Vily1998/CPU-Implementation-based-on-Proteus/截图 (5).jpg

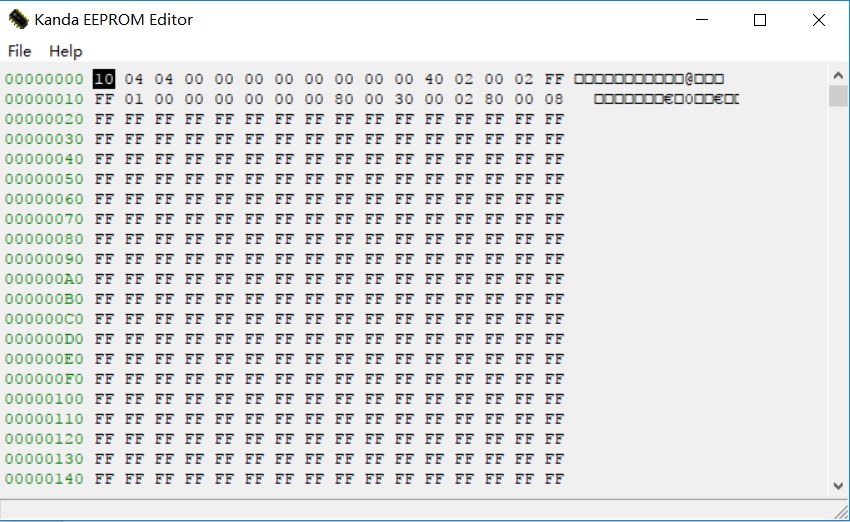
截图 (5).jpg
