Vily1998/CPU-Implementation-based-on-Proteus/微程序流程图.pptx

11
MBUS
LIR
PCINC
ARINC
P1

00
PCBUS
LAR

INT=0

1B
PUSH
RBUS
LAR

IN
1100

0C
MBUS
LAR
PCINC
STOP

18
SBUS
MEMW
P3

P3

1A
INTDI
PCBUS
LIAR

INT=1

P1

1D
SBUS
LPC

LAD
1001

09
MBUS
LAR
PCINC

15
MBUS
LDT
DRW
P3

1C
TRI
S=1010
M
ABUS
MEMW
STOP

JMP
1010

0A
MBUS
LPC
P3

JC
0100

04
P2

EI
1011

0B
INTEN

OUT
1101

0D
MBUS
LAR
PCINC

STP
1110

ADD
0001

01
S=1001
CIN
ABUS
LDT
DRW
LDC
P3

SUB
0010

02
S=0110
ABUS
LDT
DRW
LDC
P3

CLA
0011

03
M
S=0011
ABUS
LDT
DRW
P3

IRET
0101

PUSH
0110

06
PUSH
RBUS
LAR

16
S=1010
M
ABUS
MEMW
P3

POP
0111

07
RBUS
LAR

STO
1000

08
MBUS
LAR
PCINC

14
S=1010
MEMW
M
ABUS
P3

05
RBUS
LAR

1E
MBUS
LDT
TRI
DRW
POP

1F
IABUS
LPC
P3

0E
STOP
P3

C=0

P2

12
P3

C=1

13
PCADD
P3

17
MBUS
LDT
DRW
POP
P3

19
MBUS
LDO
P3

## Slide 2

memory
ROM | 0000-7FFF | 测试程序 + 初始数据
RAM | 8000-CFFF | 主程序写入的数据
| D000-DFFF | 中断写入的数据
| E000-EFFF | 栈
| F000-FFFF | I/O

## Slide 3

元件一览表
元件名 | | | 功能
ALU | 算术逻辑运算单元 | Arithmetic logic state | 运算，主要利用74ls181和74ls182芯片实现。
PRO | 处理程序 | Processor | 寄存器+选择器，内含1个累加器AC，三个寄存器R0,R1,R2，通过输入信号选择写入的信号和ALU运算的操作数，DRW信号控制写操作。
DR | 数据缓冲寄存器 | Data register | 用来暂时存放ALU的运算结果。
RAM+ROM | 存储器 | Random access memory Read only memory | 内存部分，用两片27C512（64K 八位ROM）芯片做成地址为16位的ROM部分，用两片64K八位RAM芯片实现地址为16位的RAM。
AR | 地址寄存器 | Address register | 用来记录将要访问的内存地址，可以通过LAR信号完成将总线上数据置入的操作，可以通过ARINC信号完成地址自增操作。
PC | 程序计数器 | Program counter | 用来记录当前执行的程序地址，可以通过PCINC完成地址自增操作， 通过PCADD进行地址转移，从而使程序可以循环执行。
IR | 指令寄存器 | Instruction register | 用来存储当前执行的指令，在取值周期通过置数信号LIR有效将取出的地址置入IR。
TIME | 时序电路 | Time | 生成四个相邻且互不相重合的时钟脉冲，用来控制整个程序的时序执行。
ITC | 中断触发电路 | Interrupt trigger circuit | 产生中断信号，在pause按钮按下后产生一个中断请求，并在中断程序执行周期内禁止其他中断请求。
IAR | 中断地址寄存器 | Interrupt address register | 记录终端时程序执行到了地址，在LAR信号作用下将中断地址存入IAR，在中断结束后将中断地址返回。

## Slide 4

元件一览表（续）
元件名 | | | 功能
PSW | 状态字寄存器 | Programming status word register | 记录C信号的状态，可以在程序进入中断时通过TRA信号切换至中断模式，保留主程序的状态字，同时可以存储中断程序的状态字。
SAR | 栈地址寄存器 | Stack address register | 用来存放栈地址，配合push，pop操作实现栈结构。
CM | 控制存储器 | Command register | 将指令转换成40位微地址。
MCR | 微命令寄存器 | Microcommand register | 存储微命令，对垂直型微命令进行译码。本设计采用水平型微指令，无需译码。
ATL | 地址转移逻辑 | Address transfer logic | 通过P字段判别对微指令给出的下一位微地址。
IN | 输入元件 | Input element | 配合IN指令和中断指令，实现程序执行时输入数据或地址。
OUT | 输出元件 | Output element | 配合OUT指令，实现程序执行时查询内存指定区域的数据。
RC | 寄存器控制器 | Register controller | 实现指令和中断微指令对通用寄存器的选择。

## Slide 5

分工一览表
姓名 | 自制元件 | 工程设计
陈博 | DR,AR,PC,SAR,PSW,ATL | 12条微指令设计，时序分配，地址转移逻辑设计，程序正确性调试,栈存在逻辑设计，数据流动情况分析，控制开关复用模式设计。
刘佳玮 | IR,IAR,MCR,ITC,TIME,RC | 18条微指令设计，中断电路设计，测试程序设计，程序正确性调试，时序产生逻辑设计，总线使用情况分析，输入输出逻辑设计。
张绍磊 | RAM+ROM,CM,ALU,PRO，Python写入ROM程序 | 指令格式设计，微指令代码编写，ROM数据存储，测试程序设计，程序正确性调试，中间信号显示设计，微指令译码逻辑设计。
