Vily1998/CPU-Implementation-based-on-Proteus/演示文稿1.pptx

开关说明
START | 1.开机功能，一次脉冲后开始产生时序信号 2.输入确认功能，程序等待输入时，输入完成后，通过一次START脉冲继续执行程序。
PCCLR | 1.PC清零功能，开机后通过一次PCCLR脉冲，可以将指令地址清零，回到程序的开始地址。
STEP | 1.操作模式切换开关，当STEP为0时，程序为连续运行模式，当STEP为1时，程序为单排运行模式。
PAUSE | 1.程序中断请求信号，单击PAUSE，程序开始中断。

## Slide 2

操作步骤
1.主程序操作步骤
1）开始PROTUES仿真
2）点摁PCCLR，清零PC
3）点摁START，开始执行程序
2.I/O交换
1）当程序运行到IN指令后，就需要我们从输入区输入数据。
2）此时，程序会停止运行，在输入区输入需要的数据。
3）输入完成后，单击START确认输入，继续运行程序。
3.中断操作步骤
1）单击PAUSE，产生中断请求。
2）程序将继续运行，直到程序执行完当前指令，然后程序将停止等待输入。
3） 在输入区输入中断地址，在我们设计的 程序中，两个中断子程序分别位于 3000和3100。输入完地址后，单击START确认输入，继续运行程序。

## Slide 3

简单测试程序
内存地址 | 汇编指令 | 机器代码 | AC | R1 | R2 | R3 | 说明
0000 | LAD(0010)->RI | 9100 | 0000 | 0008 | 0000 | 0000 | 将地址0010的数据 存入R1
0001 | | 0010
0002 | LAD(0011)->R2 | 9200 | 0000 | 0008 | 0005 | 0000 | 将地址0011的数据 存入R2
0003 | | 0011
0004 | ADD R1 | 1400 | 0008 | 0008 | 0005 | 0000 | AC+R1->AC
0005 | SUB R2 | 2800 | 0003 | 0008 | 0005 | 0000 | AC-R2->AC
0006 | STO AC->(8000) | 8000 | 0003 | 0008 | 0005 | 0000 | 将AC的数据 存入地址8000
0007 | | 8000
0010 | | 0008 | | | | | 数据
0011 | | 0005 | | | | | 数据

## Slide 4

内存地址 | 汇编指令 | 机器代码 | AC | R1 | R2 | R3 | 说明
000D | LAD(4002)->R3 | 9300 | 0000 | A000 | 6000 | 2000 | 将地址4002的数据 存入R3
000E | | 4002
000F | PUSH AC | 6081 | 0000 | A000 | 6000 | 2000 | AC数据入栈
0010 | CLA | 3000 | 0000 | A000 | 6000 | 2000 | 清零AC
0011 | POP AC | 7000 | 0000 | A000 | 6000 | 2000 | 栈顶数据进入AC
0012 | ADD R3 | 1C00 | X000 (X不断+2) | A000 | 6000 | 2000 | AC+R3->AC
0013 | JC 02 | 4002 | X000 | A000 | 6000 | 2000 | 通过C判断是否跳转之0016
0014 | JMP(000F) | A000 | X000 | A000 | 6000 | 2000 | 跳转至000F
0015 | | 000F
0016 | STP | E000 | | | | | 停机

## Slide 5

内存地址 | 汇编指令 | 机器代码 | 说明
3000 | SUB R3 | 2C00 | AC-R3->AC
3001 | SUB R3 | 2C00 | AC-R3->AC
3002 | EI | B000 | 中断允许
3003 | IRET | 5000 | 中断返回
3100 | IN | C000 | 从输入区输入数据
3101 | | F000
3102 | ADD R3 | 1C00 | AC+R3->AC
3103 | OUT | D000 | 输出数据
3104 | | F000
3105 | EI | B000 | 中断允许
3106 | IRET | 5000 | 中断返回

## Slide 6

内存地址 | 汇编指令 | 机器代码 | 说明
4000 | | A000 | 数据
4001 | | 4000 | 数据
4002 | | 2000 | 数据
