Vily1998/CPU-Implementation-based-on-Proteus/截图 (2).jpg

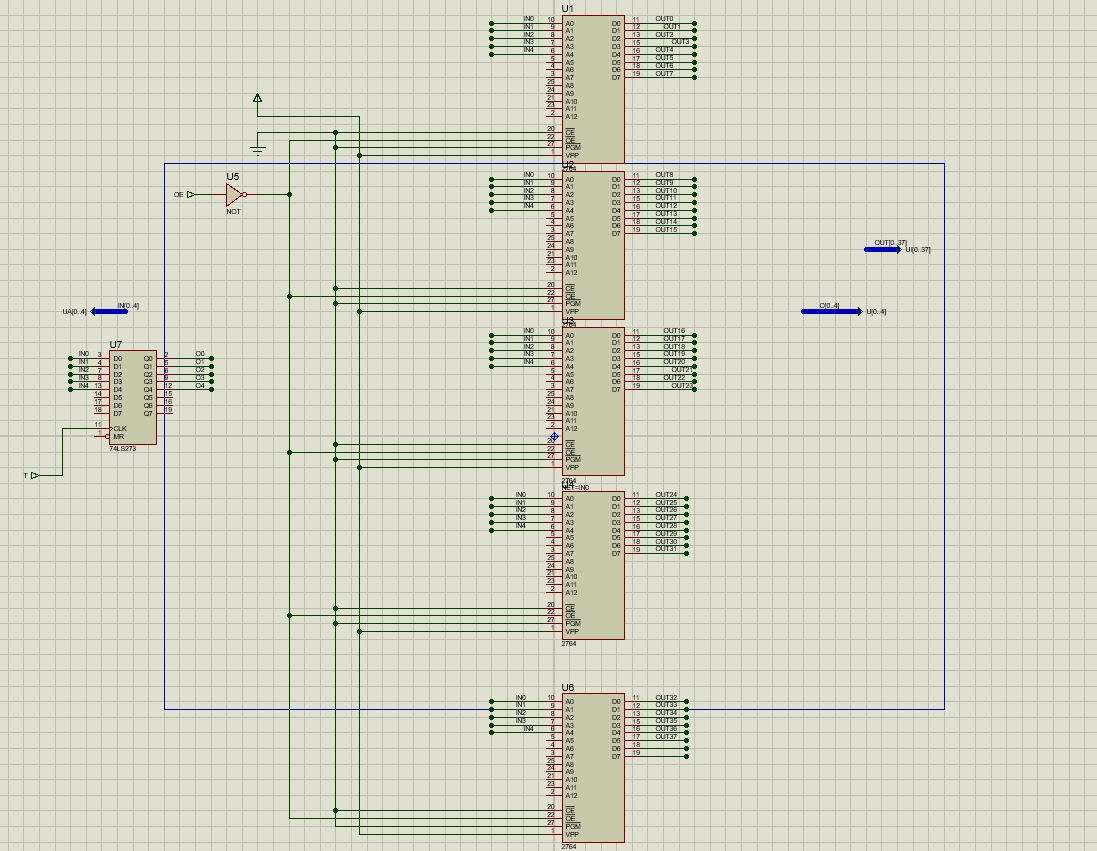
截图 (2).jpg
