Vily1998/CPU-Implementation-based-on-Proteus/截图 (3).jpg

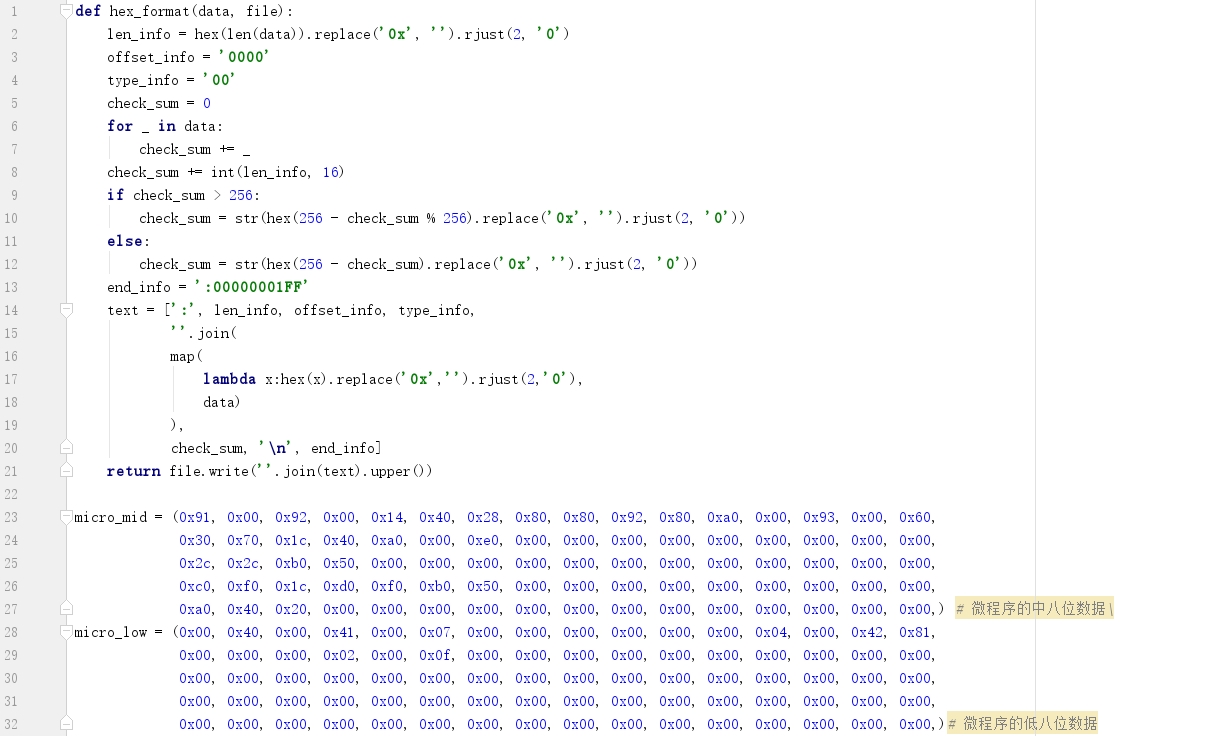
截图 (3).jpg
