Vily1998/CPU-Implementation-based-on-Proteus/(list of files, drawings)

Other design files:
Beta100.0终极美化版/Beta终极美化版.pdsprj
CPU_中间版本/16位算逻运算器.pdsprj
CPU_中间版本/ALU+AR+PC+IR+RAM+IAR (1).pdsprj
CPU_中间版本/ALU+AR+PC+IR+RAM+IAR+TIME (1).pdsprj
CPU_中间版本/ALU+AR+PC+IR+RAM+IAR+TIME (2).pdsprj
CPU_中间版本/ALU+AR+PC+IR+RAM+IAR+TIME (3).pdsprj
CPU_中间版本/ALU+AR+PC+IR+RAM+IAR+TIME (4).pdsprj
CPU_中间版本/ALU+AR+PC+IR+RAM+IAR+TIME+CM+MCR+IO.pdsprj
CPU_中间版本/ALU+AR+PC+IR+RAM+IAR+TIME+CM.pdsprj
CPU_中间版本/ALU+AR+PC+IR+RAM+IAR+TIME.pdsprj
CPU_中间版本/ALU+AR+PC+IR+RAM+IAR.pdsprj
CPU_中间版本/ALU+AR+PC+IR+RAM.pdsprj
CPU_中间版本/ALU+AR+PC+IR.pdsprj
CPU_中间版本/Beta0.0ALU+AR+PC+IR+RAM+IAR+TIME+CM+MCR+IO+ROM+测试hex/ALU+AR+PC+IR+RAM+IAR+TIME+CM+MCR+IO+ROM.pdsprj
CPU_中间版本/Beta0.1测试版/更新版.pdsprj
CPU_中间版本/Beta0.1测试版/更新版（自动版旧）.pdsprj
CPU_中间版本/Beta0.1测试版/更新版（自动版）.pdsprj
CPU_中间版本/Beta0.2可运行版/Beta1.0自动版.pdsprj
CPU_中间版本/Beta1.0自动版/Beta1.0自动版.pdsprj
CPU_中间版本/Beta1.1自动版/Beta1.0自动版.pdsprj
CPU_中间版本/Beta2.0自动版/Beta2.0自动版.pdsprj
CPU_中间版本/Beta2.1自动版/Beta2.1自动版.pdsprj
CPU_中间版本/Beta2.2版/Beta2.2.pdsprj
CPU_中间版本/Beta2.3无敌版/Beta2.1自动版.pdsprj
CPU_中间版本/Beta2.4蒟蒻版/Beta2.1自动版.pdsprj
CPU_中间版本/Beta2.5蒟蒻版/Beta蒟蒻版/Beta2.1自动版.pdsprj
CPU_中间版本/Beta2.6蒟蒻版/Beta蒟蒻版/Beta2.1自动版.pdsprj
CPU_中间版本/Beta3.0版/Beta3.0.pdsprj
CPU_中间版本/Beta3.01版/Beta3.0.pdsprj
CPU_中间版本/Beta3.02版/Beta3.0.pdsprj
CPU_中间版本/Beta4.0简单程序测试版/Beta4简单程序测试版.pdsprj
CPU_中间版本/Beta4.1简单程序无敌版/Beta4简单程序测试版.pdsprj
CPU_中间版本/Beta5.0终极程序测试版/Beta4简单程序测试版.pdsprj
CPU_中间版本/Beta5.1终极程序测试版/Beta5.1终极程序测试版.pdsprj
CPU_中间版本/Beta5.2终极程序测试版/Beta4简单程序测试版.pdsprj
CPU_中间版本/Beta5.3终极程序测试版/Beta4简单程序测试版.pdsprj
CPU_中间版本/Beta5.4限定版/Beta4简单程序测试版.pdsprj
CPU_中间版本/Beta6.0停不下来版/Beta6.0停不下来版.pdsprj
CPU_中间版本/Beta6.1能停下来版/Beta6.0停不下来版.pdsprj
CPU_中间版本/Beta10.0屌炸天版/Beta10.0吊炸天版.pdsprj
CPU_中间版本/Beta完结撒花/Beta最终版.pdsprj
提交版/计组CPU大作业.pdsprj
